dkflsrj/processor-test/wiki/PerfomanceTime.wiki

#summary Времена выполнения микроконтроллером разных процессов

|| *Процесс* || *Время выполнения* ||
||Запуск МК||~300мкс||
||Время съём байта TIC||4мкс||
||Общее время съёма пакет HVE||~72мкс||
||Время декодирования HVE пакета||~13мкс||
||Время на отправку запроса HVE (с таймером)||~3 500мкс||
||Время на отправку CRITICAL_ERROR||~250мкс||
||Переключение pin_iHVE через gpio||~5мкс||
||Переключения iHVE (PORTC.3): [OUT,CLR,SET,TGL]||~350нс||
