dkflsrj/processor-test/Papers/Исследования.ods

DAC | ADC + | + V | ADC - | - V | ADC +/- | V +/- | k + | k - | k(+V) | k(-V) | k(DAC+) | k(DAC-)
5000 | 502 | 61,11 | 481 | 60,31 | 4,18% | 1,31% | 9,960 | 10,395 | 8,215 | 7,975 | 81,820 | 82,905
5500 | 551 | 67,27 | 529 | 66,3 | 3,99% | 1,44% | 9,982 | 10,397 | 8,191 | 7,979 | 81,760 | 82,956
6000 | 602 | 73,44 | 577 | 72,3 | 4,15% | 1,55% | 9,967 | 10,399 | 8,197 | 7,981 | 81,699 | 82,988
6500 | 652 | 79,6 | 625 | 78,29 | 4,14% | 1,65% | 9,969 | 10,400 | 8,191 | 7,983 | 81,658 | 83,025
