dkflsrj/processor-test/Papers/Конференция/Доклад .odt

### Отладочные средства

### систем сбора данных и управления параметрами

### на базе микроконтроллера ATxmega32A4

### в приборах физического эксперимента

Системы сбора данных и управления параметрами в физических экспериментах часто строятся с использованием микроконтроллеров. Так для управления узлами, создаваемого в лаборатории масс-спектрометра был выбран микроконтроллер типа ATxmega32A4. Для отладки его многочисленных функций целесообразно осуществить предварительную разработку и отладку программного обеспечения микроконтроллера. В данном докладе рассмотрены отладочные средства, включающие специально разработанную плату и компьютерную программу, обеспечивающие разработку и отладку программного обеспечения аппаратуры, создаваемой на микроконтроллере типа ATxmega32A4.

Микроконтроллер ATxmega32A4 и его основные возможности.

XMEGA A — семейство экономичных, высокопроизводительных микроконтроллеров, выполненных по улучшенной RISC-архитектуре AVR. Микроконтроллер ATxmega32A4 интегрирует следующие ресурсы:

- внутрисистемно-программируемая Flash-память,
- внутренние EEPROM и SRAM,
- четырёхканальный DMA-контроллер,
- восьмиканальная система событий,
- программируемый многоуровневый контроллер прерываний,
- 34 линии ввода-вывода общего назначения,
- 16-битный счётчик реального времени (RTC),
- пять 16-битных таймер-счётчиков,
- пять интерфейсов USART,
- два интерфейса SPI,
- интерфейс внутрисхемного программирования PDI
- точный внутренний генератор и предделитель частоты,
- и другое...
