dkflsrj/processor-test/Papers/Others/commands.htm

Команды масспектрометра

Cmd_GetState (0x01)

Возвращает текущее состояние масспектрометра:

Командв: 0x01

Ответ: 0x01 <SystemState>

enum SystemStates

{

SystemStart = 0,

SystemInit = 1,

SystemVacuumInit = 2,

SystemVacuumCrash = 3,

SystemReady = 4,

SystemBringingProbe = 5,

SystemMeasuring = 6,

SystemMeasured = 7,

SystemMeasuredReady = 8,

SystemPreShutdown = 9,

SystemShutdown = 10

};

Cmd_GetStatus (0x02)

Возвращает статусную информацию о системе

Команда: 0x02

Ответ: 0x02 <SystemState> <VacuumState> <Forvacuum> <HighVacuum> <HeatCurrent> <EmissionCurent> <IonizationVoltage> <FocusVoltage1> <FocusVoltage2> <ScanVoltage> <CondenserVoltagePositive> <CondenserVoltageNegative> <DetectorVoltage> <RelaysValvesState>

Где:

<SystemState>

enum SystemStates

{

SystemStart = 0,

SystemInit = 1,

SystemVacuumInit = 2,

SystemVacuumCrash = 3,

SystemReady = 4,

SystemBringingProbe = 5,

SystemMeasuring = 6,

SystemMeasured = 7,

SystemMeasuredReady = 8,

SystemPreShutdown = 9,

SystemShutdown = 10

};

<VacuumState>

enum VacuumStates

{

VacuumIdle = 0,

VacuumInit = 1,

VacuumWaitForvacuum = 2,

VacuumCheckForvacHvac = 3,

VacuumWaitOpenHValve = 4,

VacuumWaitForvacuum2 = 5,

VacuumWaitHighvacuum = 6,

VacuumReady = 7,

VacuumBringProbe = 8,

VacuumBringProbeWaitHvacuum = 9,

VacuumForvacuumCrash = 10,

VacuumForvacuumCrashTime = 11,

VacuumForvacuumCrashTime2 = 12,

VacuumHighvacuumCrash = 13,

VacuumHighvacuumCrashTime = 14,

VacuumShutdown = 15

};

<Forvacuum> <HighVacuum> <HeatCurrent> <EmissionCurent> <IonizationVoltage> <FocusVoltage1> <FocusVoltage2> <ScanVoltage> <CondenserVoltagePositive> <CondenserVoltageNegative> <DetectorVoltage>

Соответствующие значения АЦП. Каждое значение представлено 16-битным числом (младший бай первый в пакете), действительных бит – 12 (т.е. старшие 4 бита не используются).

<RelaysValvesState>

Текущее состояние всех реле и клапанов. Каждый би отвечает за соответствующее реле или клапан:

0 – ForvacuumPumpState : 0 – форвакуумный насос выключен, 1 – включен

1 – AtmLapValve: 0 – клапан выхода в атмосферу закрыт, 1 – открыт

2 – HighVacuumValve: 0 - клапан между высоковакуумным насосом и форвакуумом закрыт, 1 – открыт

3 – HeatValve: 0 – тепловой вентиль закрыт, 1 – открыт

4 – PackRelay: 0 – отжимное реле экстрактора (карамысла) выключено, 1 – включено

5 – BringProbeRelay: 0 – реле введения пробы выключено, 1 – включено

6 – RotationRelay: 0 – реле вращения карамысла выключено, 1 – включено

7 – HVHardwEnabled: 0 – высокое напряжение запрещено аналоговой частью, 1 – разрешено (не обязательно включено, это просто превышение минимального порога; высокое напряжение включается только при переходе системы в состояние SystemReady при условии, что бит HVHardwEnabled находится в состоянии 1).

В эту команду так же будет добавлена информация о высоковакуумном насосе (температура, RPM и состояние – включен или выключен).

Cmd_Shutdown (0x03)

Переводит систему в состояние Shutdown. При этом все узлы приводятся в первоначальное состояние. Выход из этого состояние возможен только по команде Cmd_Init.

Cmd_Init (0x04)

Запускает инициализацию системы (в том числе откачку вакуума). Команда может быть исполнена только при нахождении системы в состояниях SystemVacuumCrash, SystemShutdown.

Cmd_SetHeatCurrent (0x05)

Устанавливает значение тока нагрева.

Формат: 0x05 <dataL> <dataH>

Передаются в качестве значения тока два байта (т.е. 16-битное число), но действующими битами являются только младшие 12. При непопадании данных в заданный диапазон (12-бит), генерируется ошибочный ответ (Error_InvalidData).

Cmd_SetEmissionCurrent (0x06)

Устанавливает значение тока эмиссии.

Формат: 0x06 <dataL> <dataH>

Передаются в качестве значения тока два байта (т.е. 16-битное число), но действующими битами являются только младшие 12. При непопадании данных в заданный диапазон (12-бит), генерируется ошибочный ответ (Error_InvalidData).

Cmd_SetIonizationVoltage (0x07)

Устанавливает значение напряжения ионизации.

Формат: 0x07 <dataL> <dataH>

Передаются в качестве значения напряжения два байта (т.е. 16-битное число), но действующими битами являются только младшие 12. При непопадании данных в заданный диапазон (12-бит), генерируется ошибочный ответ (Error_InvalidData).

Cmd_SetFocusVoltage1 (0x08)

Устанавливает значение первого фокусирующего напряжения.

Формат: 0x08 <dataL> <dataH>

Передаются в качестве значения напряжения два байта (т.е. 16-битное число), но действующими битами являются только младшие 12. При непопадании данных в заданный диапазон (12-бит), генерируется ошибочный ответ (Error_InvalidData).

Cmd_SetFocusVoltage2 (0x09)

Устанавливает значение первого фокусирующего напряжения.

Формат: 0x09 <dataL> <dataH>

Передаются в качестве значения напряжения два байта (т.е. 16-битное число), но действующими битами являются только младшие 12. При непопадании данных в заданный диапазон (12-бит), генерируется ошибочный ответ (Error_InvalidData).

Cmd_SetScanVoltage (0x0a)

Устанавливает значение сканирующего напряжения.

Формат: 0x0a <dataL> <dataH>

Передаются в качестве значения напряжения два байта (т.е. 16-битное число), но действующими битами являются только младшие 12. При непопадании данных в заданный диапазон (12-бит), генерируется ошибочный ответ (Error_InvalidData).

Cmd_SetCondenserVoltage (0x0b)

Устанавливает значении напряжения конденсатора.

Формат: 0x0b <dataL> <dataH>

Передаются в качестве значения напряжения два байта (т.е. 16-битное число), но действующими битами являются только младшие 12. При непопадании данных в заданный диапазон (12-бит), генерируется ошибочный ответ (Error_InvalidData).

Cmd_Measure (0x0c)

Запускает измерение одной точки. В качестве данных передается время ожидания до начала измерения (время установления ScanVoltage) и время измерения. Ответ на команду – что команда исполнена. После чего система переходит в состояние SystemMeasuring. По окончании измерения (истечении времени ожидания и вемени измерения) система переходит в состояние SystemMesaured и генерируется асинхронное сообщение Async_Measured. После чего может быть послана команда Cmd_GetCounts.

Формат: 0x0c <WaitTimeL> <WaitTimeH> <MeasureTimeL> <MeasureTimeH>

Время задается в 5-миллисекундных интервалах.

Cmd_GetCounts (0x0d)

Читает значение счетчиков и переводит систему из состояние SystemMeasured в состояние SystemReady.

Формат: 0x0d

Ответ: 0x0d <Detector0L> <Detector0M> <Detector0H> <Detector1L> <Detector1M> <Detector1H>

Ответом является пакет, в котором содержатся 24-битные значения счетчиков двух детекторов. Каждое значение идет младшим байтом вперед.

Cmd_RotateExtractor (0x0e)

Запускает процедуру вращения экстрактора (коромысла). Т.е. отжимает экстрактор, переворачивает, прижимает.

Cmd_RotateExtractorGetState (0x0f)

Возвращает текущее состояние вращения экстрактора.(0 – Stopped, 1 – Rotating). Позволяет узнать когда экстрактор закончил вращение.

Формат: 0x0f

Ответ: 0x0f <State>

Cmd_BringProbe (0x10)

Вводит пробу в экстрактор. В качестве данных передается количество впрысков.

Формат: 0x10 <Num>

Где Num – количество впрысков.

Cmd_EnableHeatCurrent (0x11)

Включает или выключает ток нагрева. Если данные равны 0 – то выключает, если не равны нулю – то включает.

Формат: 0x11 <Enable:bool>

Cms_EnableEmissionCurrent (0x12)

Включает или выключает ток эмиссии. Если данные равны 0 – то выключает, иначе – включает.

Формат: 0x12 <Enable:bool>

Так же возможны ответы на команды в случае каких-либо ошибок:

enum ErrorReplyes

{

Error_InvalidCommand=64,

Error_InvalidChecksum=128,

Error_InvalidPacket = 129,

Error_InvalidLength = 130,

Error_InvalidData = 131,

Error_InvalidState = 132

};

Error_InvalidCommand – неверный код команды (команды с таки кодом нет)

Error_InvalidChecksum – неверная контрольная сумма пакета

Error_InvalidPacket – ошибки при принятии пакета (типа overrun или что-то подобное)

Error_InvalidLength – неверная длинна пакета/данных

Error_InvalidData – неверные данные (например выходят за допустимый диапазон)

Error_InvalidState – команда не может быть исполнена в текущем состоянии системы

Возможны асинхронные пакеты, которые сообщают о каком-то событии в системе:

enum AsyncReplyes

{

InternalError = 192,

InternalError_InvalidSystemState = 193,

AsyncError_VacuumCrash = 194,

Async_Measured=224,

Async_VacuumReady = 225,

Async_SystemShutdowned = 226,

Async_Init = 227

};

InternalError – полный трынцец. Случилось что-то страшное. Срочно все выключаем. Никогда не должно возникнуть. Данные, пересланные в этом пакете необходимо сохранить и показать мне.

InternalError_InvalidSystemState – почти полный трындец. Почему-то возникло неизвестное системное состояние. Срочно выключаем. Никогда не должно возникнуть. Аналогично – все данные отсюда надо сохранить и показать мне.

AsyncError_VacuumCrash – что-то страшное случилось с вакуумом. Т.е. либо форвакуум, либо высокий вакуум стал хуже заданного порога. В качестве данных передается состояние вакуума. Более подробную информацию можно получить по команде Cmd_GetStatus.

Async_Measured – измерение закончено.

Async_VacuumReady – вакуум перешел в состояние VacuumReady, следовательно система перешла в состояние SystemReady и готова к измерению.

Async_SystemShutdowned – система перешла в состояние SystemShutdown (по команде Cms_Shutdown).

Async_Init – запущена циклограмма инициализации системы/вакуума (либо при включении питания, либо по команде Cmd_Init).
