dkflsrj/processor-test/Papers/Others/Прибор/1-3-poryadok_vkl_med-pribora.bmp

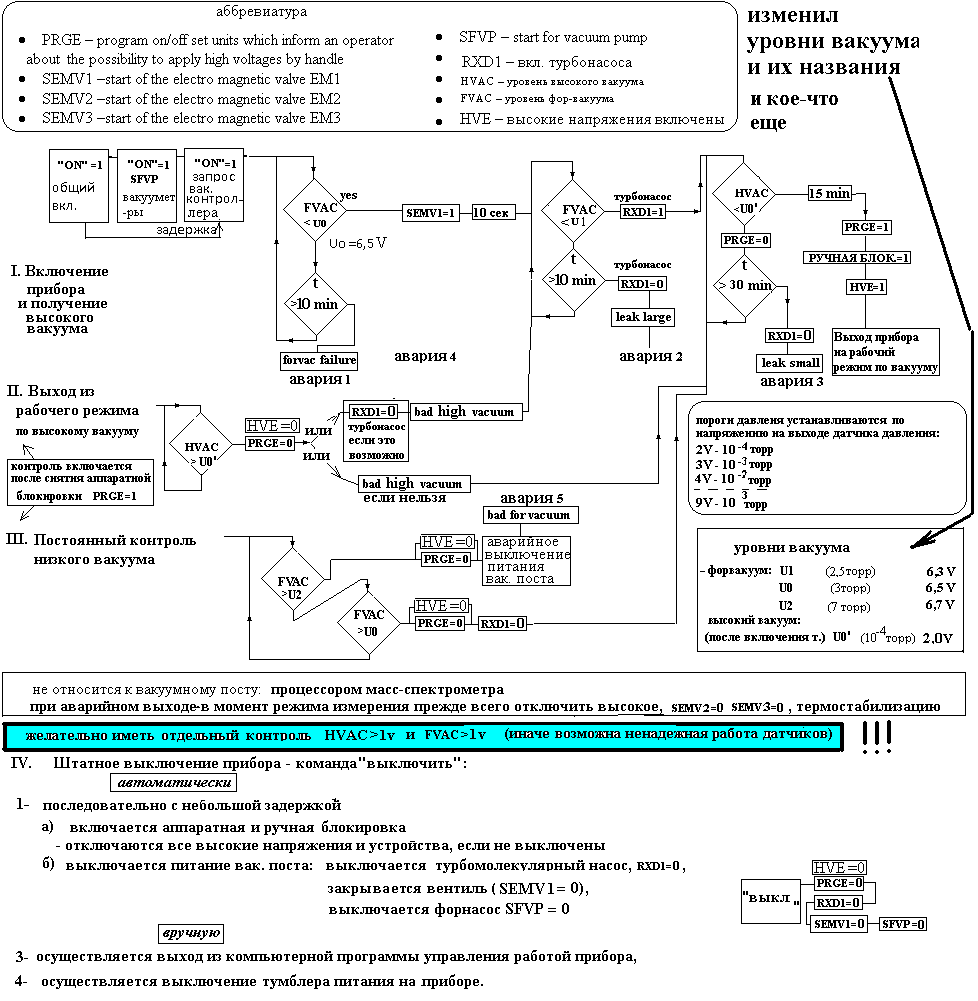
Papers/Others/Прибор/1-3-poryadok_vkl_med-pribora.bmp
