dkflsrj/processor-test/Papers/Конференция/Картинки/pic_3_1.GIF

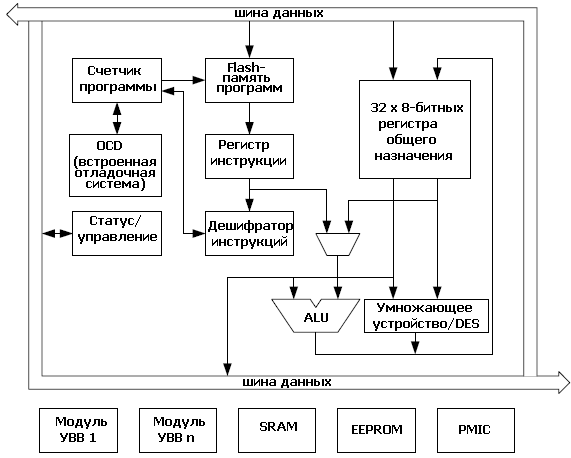
Papers/Конференция/Картинки/pic_3_1.GIF
