dkflsrj/processor-test/Papers/Конференция/Картинки/Схема МК семейства XMEGA A.gif

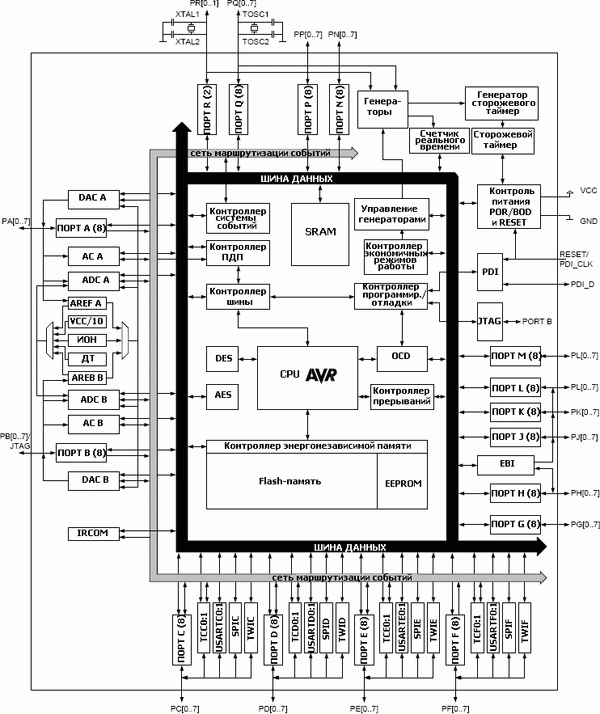
Papers/Конференция/Картинки/Схема МК семейства XMEGA A.gif
