dkflsrj/processor-test/Papers/Конференция/Картинки/Схема установки.PNG

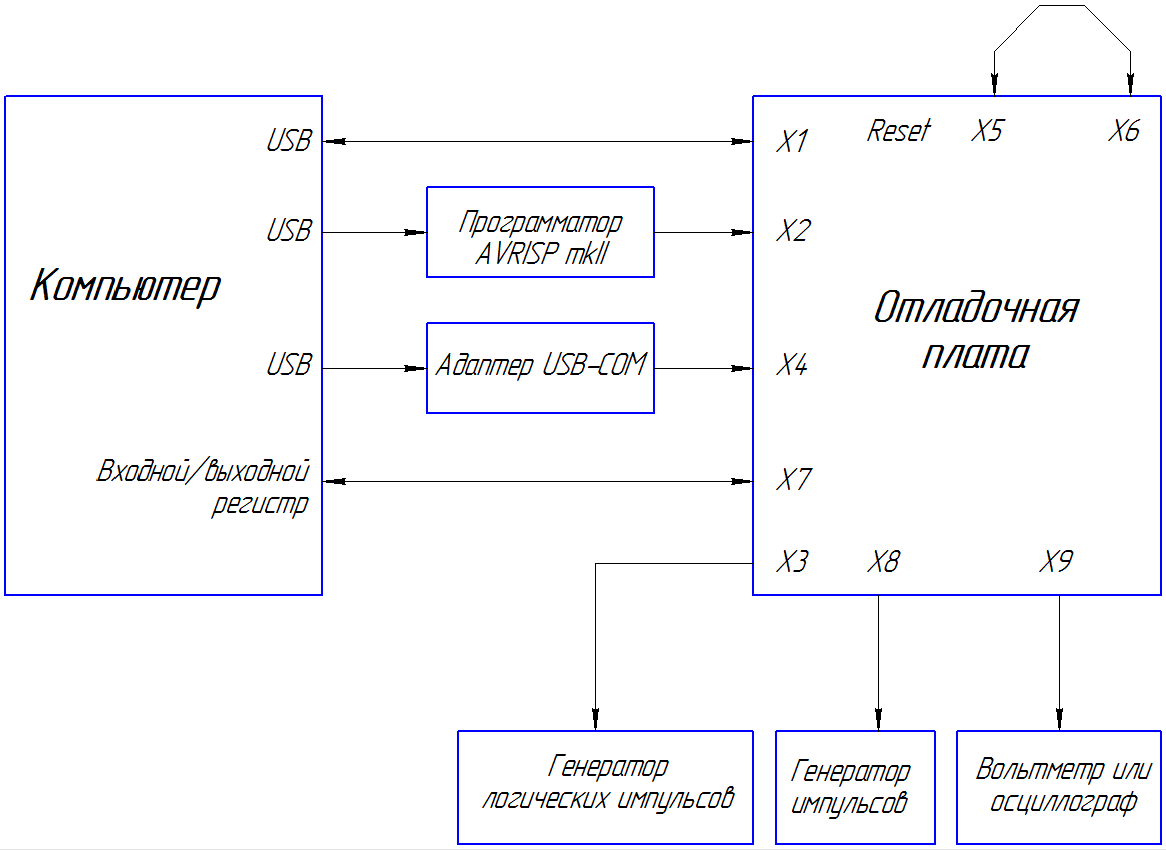
Papers/Конференция/Картинки/Схема установки.PNG
