dkflsrj/processor-test/PCAD/Test/Чичагов/Controller Test.XLS

 |  |  |  |  |  |  |  |  | ИЗМ.
ЗАКАЗЧИК |  |  |  |  |  |  |  | вер. 13.10.07
Название фирмы (или ФИО) - заказчика |  |  |  | ИНН\КПП | ФТИ им.Иоффе
Плательщик (если различно с заказчиком) |  |  |  | ИНН\КПП | ООО “МАКСВЕЛЛ” ИНН 7814122106 КПП 780401001
Адрес (юридический) |  |  |  |  | Адрес:195257, г. С. -Петербург, пр. Северный, д.73/2-54
Телефон / Факс |  |  |  |  | тел. 2927962, +79112877645, 2927361 факс. (812) 297-3145
e-mail |  |  |  |  | tuboltsev@mail.ioffe.ru
Контактное лицо |  |  |  |  | Тубольцев Юрий Владимирович
Способ доставки |  | Адрес доставки |  |  | Самовывоз
Характеристика проекта |  |  |  |  | Все значения и требования отличные от стандартных необходимо дописывать в поле "ДОПОЛНИТЕЛЬНЫЕ ТРЕБОВАНИЯ"
Название файла платы: |  |  |  |  | Controller Test.pcb
Тип заказа |  |  |  |  | Новый
Вариант производства |  |  |  |  | Срочное изготовление(2-4дня)
Количество, шт. |  |  |  |  | 1
Размер платы (длина), мм
Размер платы (ширина), мм
Общая площадь платы, дм*дм (вычисляется автоматически)
Формат файлов
Общая толщина платы, мм (по умолчанию 1,5мм) |  |  |  |  | 1.50
Толщина фольги, мкм (по умолчанию 18мкм) |  |  |  |  | 18
Количество слоев |  |  |  |  | 2
Наличие маски |  |  |  |  | с 2 сторон
Наличие маркировки краской |  |  |  |  | Отсутствует
Переходные отверстия (по умолчанию закрыты маской) |  |  |  |  | Открыты от маски
Масштаб изготовления фотошаблона
Мехобработка контура (по умолчанию на выбор производства) |  |  |  |  | Фрезерование
Электроконтроль |  |  |  |  | нет
Монтаж в нашей фирме |  |  |  |  | нет
Дополнительные требования
Перечень технологических слоев (предполагается описание максимум 5 проектов при одинаковой структуре слоев)
Указать, какие характеристики каждого слоя включить в вашем проекте, пометить любым знаком
Верхний | Нижний |  | Маска верх | Маска низ |  | контур
Top | Bottom |  | MaskTop | MaskBot |  | Border
RefDes | RefDes |  | Pad | Pad
Type | Type |  | RefDes | RefDes
Value | Value |  | Type | Type
 |  |  | Value | Value
 |  |  |  |  |  |  | другие слои не указанные выше, (если есть или отличаются)
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
