dkflsrj/processor-test/Papers/ListOfCommandsForTestBoard.ods

Sheet: Структура пакетов
Любая команда ПК имеет вид: |  |  |  | <KEY><command><data><CS><LOCK> | До 10 байт
Любой ответ МК имеет вид: |  |  |  | <KEY><response><data><CS><LOCK> | Любого размера
Блок | Кол. Байт | Число | Символ
<KEY> | 1 | 58 | :
<command> | 1 | any | any
<data> | any | any | any
<CS> | 1 | 256 - <command> - <data>
<LOCK> | 1 | 13 | \r
<response> | 1 | <command> или <ErrorToken>
<ErrorTocken> | 1 | 0

Sheet: Команды
Код | Название |  |  |  |  | Данные |  | Описание
 | МК | ПК |  |  | Коротко | Посылаемые | Принимаемые
 |  | Тип | Имя | Перезагрузки
0 | ErrorToken | - | - | - | Метка ошибки | ? | 2 байта | Отклик МК, означающий, что следующие данные содержат информацию об ошибке
1 | MC_get_Version | byte | getVersion | - | Запросить версию прошивки МК | - | 1 байт | МК возвращает версию прошивки МК
2 | MC_get_Birthday | string | getBirthday | - | Запросить дату создания прошивки | - | 4 байта | МК возвращает дату создания прошивки МК
3 | MC_get_CPUfreq | string | getCPUfrequency | - | Запросить частоту МК | - | 4 байта | МК возвращает частоту процессора (не вычисляется)
4 | MC_reset | bool | reset |  | Перезагрузка МК | - | - | МК перезагружается [НЕ РАБОТАЕТ – ОТКЛЮЧЕНО]
5 | MC_wait | void | setMCwait |  | Перевод в режим ожидания | - | - | Переводит МК в режим ожидания [НЕ РАБОТАЕТ – ОТКЛЮЧЕНО]
6
7
8 | checkCommandStack | bool | checkCommandStack | - | Проверить стек команд | - | 1 байт | МК возвращает CommandStack (ПК и МК считают выполненные команды)
9
10 | showMeByte | void | showMeByte(BYTE) | byte \ string \ uint | Показать байт на светодиодах | 1 байт | - | МК показывает byte на светодиодах. [ОТКЛИК ОТКЛЮЧЕН]
11 | retransmitToTIC | void | sendToTIC | - | Ретранслировать команду на TIC | ? | ? | МК ретранслирует команду TIC'у, ивозвращает компьютеру ответ TIC'a [В РАЗРАБОТКЕ...]
12
13 | LOCK | - | - | - | Затвор | - | - | \r' – Конец команды. Любая команда заканчивается этой
14
15
16
17
18
19
20 | MC_get_Status | byte | getStatus | - | Запросить состояние МК | - | - | Возвращает код состояния МК
21
22
23
24
25
26
27
28
29
30 | RTC_set_Period | bool | COUNTERS.setMeasureTime(MILLISECONDS) | uint | string | Задать время измерения | 2 байта | 1 байт | Задаёт время измерения от 1мс до 2047с. Возвращает статус RTC
31 | COUNTERS_start | bool | COUNTERS.startMeasure | - | Начать счёт | - | 1 байт | Счётчики начинаю считать импульсы, а RTC – время. Возвращает статус
32 | COUNTERS_get_Count | string | COUNTERS.getResults | - | Запросить у счётчиков результаты | - | 15 байт | Запросить у счётчиков результаты и переполненность
33 | COUNTERS_stop | bool | COUNTERS.stopMeasure |  | Остановить счётчики | - | - | Счётчики останавливаются, результаты сбрасываются. RTC останавливается и сбрасывается
34 | RTC_set_Prescaler | bool | COUNTERS.setPrescaler(PRESCALER) | ushort | Задать делитель RTC | 1 байт | - | RTC устанавливает соответствующий делитель
35 | RTC_get_Status | string | COUNTERS.getStatus | - | Запросить статус RTC | - | 1 байт | МК возвращает статус RTC
36 | RTC_set_Delay | bool | COUNTERS.setDelay(MILLISECONDS) | uint | string | Задать время задержки | 2 байт | - | Задаёт время задержки от 1мс до 2047с. Возвращает true – удалось, false – отмена
37 | RTC_startDelay | byte | COUNTERS.startDelay() |  | Принудительно начать задержку (таймер) | - | 1 байт | Принудительно начинает задержку, может работать как таймер.
38 | RTC_set_DelayPrescaler | bool | COUNTERS.setDelayPrescaler(MILLISECONDS)
39
40 | IonSource_set_Voltage | bool | IonSource.<...>.setVoltage(VOLTAGE) | ushort | string| int | Задать напряжение DAC'у Ионного Источника | 2 байта | - | МК задаёт напряжение на DAC Ионного Источника на канал <...>
41 | Detector_set_Voltage | bool | Detector.<...>.setVoltage(VOLTAGE) | ushort | string| int | Задать напряжение DAC'у Детектора | 2 байта | - | МК задаёт напряжение на DAC Детектора на канал <...>
42 | Scaner_set_Voltage | bool | Scaner.<...>.setVoltage(VOLTAGE) | ushort | string| int | Задать напряжение DAC'у Сканера | 2 байта | - | МК задаёт напряжение на DAC Сканера на канал <...>
43 | Condensator_set_Voltage | bool | Condensator.setVoltage(VOLTAGE) | ushort | string| int | Задать напряжение конденсатора | 2 байта | - | МК задаёт напряжение на DAC Конденсатора на канал единственный используемый канал
44
45
46
47
48
49 | Inlet_set_Voltage | bool | Inlet.setVoltageVOLTAGE() | ushort | string| int | Задать напряжение натекателя | 2 байта | - | МК задаёт напряжение на DAC Натекателя на канал Натекателя
50 | Heater_set_Voltage | bool | Heater.setVoltage(VOLTAGE) | ushort | string| int | Задать напряжение нагревателя | 2 байта | - | МК задаёт напряжение на DAC Натекателя на канал Нагревателя
51
52
53
54
55
56
57
58 | KEY | - | - | - | Ключ | - | - | :' - Начало команды. Любая команда начинается с этой.
59
60 | IonSource_get_Voltage | ushort | IonSource.<...>.getVoltage | - | Запросить напряжение у ADC Ионного Источника | 2 байта | 2 байта | МК возвращает напряжение DAC Ионного Источника на канале <...>
61 | Scaner_MSV_get_Voltage | ushort | Scaner.<...>.getVoltage | - | Запросить напряжение у ADC Сканера | 2 байта | 2 байта | МК возвращает напряжение DAC Сканера на канале <...>
62
63
64 | Detector_DV1_get_Voltage | ushort | Detector.DV1.getVoltage | - | Запросить напряжение DV1 | 2 байта | 2 байта | МК возвращает напряжение DAC Детектора на канале DV1
65 | Detector_DV2_get_Voltage | ushort | Detector.DV2.getVoltage | - | Запросить напряжение DV2 | 2 байта | 2 байта | МК возвращает напряжение DAC Детектора на канале DV2
66 | Detector_DV3_get_Voltage | ushort | Detector.DV3.getVoltage | - | Запросить напряжение DV3 | 2 байта | 2 байта | МК возвращает напряжение DAC Детектора на канале DV3
67 | Inlet_get_Voltage | ushort | Inlet.getVoltage | - | Запросить напряжение натекателя | 2 байта | 2 байта | МК возвращает напряжение DAC Натекателя на канале Натекателя
68 | Heater_get_Voltage | ushort | Heater.getVoltage | - | Запросить напряжение нагревателя | 2 байта | 2 байта | МК возвращает напряжение DAC Натекателя на канале Нагревателя
69
70
71
72
73
74
75
76
77
78
79
80 | Flags_set | byte | .setFlags | byte | Устанавливаем флаги на пинах | 1 байт | 1 байт | Посылает на МК 8 бит: <Проверить\Установить><0> и 6 флагов <iHVE><iEDCD><SEMV1><SEMV2><SEMV3><SPUMP>. МК возвращает флаги в том же порядке.
81
82
83
84
85
86
87

Sheet: Ошибки
Код | Тип | Название |  | Описание | Заметки
 |  | MC | Ru
0 | Token | ERROR_Token | Метка ошибки | Метка ошибки присылается как отклик на команду, после идут данные об ошибке.
1 | external_error | ERROR_Decoder | Ошибка декодера (Команда) | МК не может интерпретировать команду. Такой команды не существует.
2 | external_error | ERROR_WhereIsKEY | Ошибка декодера (Ключ) | МК не обнаружил КЛЮЧ в полученной команде.
3 | external_error | ERROR_WhereIsLOCK | Ошибка декодера (Затвор) | МК не обнаружил ЗАТВОР в полученной команде.
4 | external_error | ERROR_CheckSum | Ошибка декодера (Контр.сумма) | Контрольная сумма полученной команды не совпадает с подсчитанной
5 | internal_error | ERROR_wrong_SPI_DEVICE_Number | Ошибка номера SPI устройства | МК было приказано обратиться к неизвестному SPI устройству. Не должна возникнуть
6
7
8
9
10
11
12
13
14
15
16
17
18
19
20
21
22
23
24
25
26
27
28
29
30
31
32
33
34
35

Sheet: Класс
СТРУКТУРА КЛАССА
MC | getErrorList() |  |  | List<string> | Возвращает список возникших при работе ошибок, которые были записаны классом.
 | Chip | setUSART(SerialPort) |  | - | Задаёт COM порт. Необходимо для инициализации
 |  | getStatus() |  | byte | Возвращает статус самого микроконтроллера
 |  | getVersion() |  | byte | Возвращает версию прошивки микроконтроллера
 |  | getBirthday() |  | string | Возвращает дату создания прошивки микроконтроллера
 |  | getCPUFrequency() |  | string | Возвращает частоту процессора микроконтроллера (не вычисляется)
 |  | checkCommandStack() |  | bool | Проверяет синхронность команд ПК-МК.
 | Tester | setTracer(RichTextBox) |  | - | Задаёт RichTextBox для вывода сообщений (опционально)
 |  | enableTracer(bool) |  | - | Включает\выключает вывод сообщений
 |  | enableLog(bool) |  | - | Включает\выключает вывод сообщений в текстовый файл Log.txt
 |  | sendSomething() |  | - | ТЕСТОВОЕ – посылает число 243 микроконтроллеру
 |  | showMeByte(byte | string | uint) |  | - | ТЕСТОВОЕ - Посылает микроконтроллеру байт, который он высвечивает на светодиодах
 | IonSource | EmissionCurrent | setVoltage(ushort | int | string) | - | Задаёт напряжение Эмиссионного Тока Ионного Источника
 |  |  | getVoltage() | ushort | Возвращает напряжение Эмиссионного Тока Ионного Источника
 |  |  | enableDoubleRange(bool) | - | Включает\выключает двойной диапазон снятия напряжения (для getVoltage() ) | <-
 |  | Ionization | setVoltage(ushort | int | string) | - | Задаёт напряжение Ионизации Ионного Источника
 |  |  | getVoltage() | ushort | Возвращает напряжение Ионизации Ионного Источника
 |  |  | enableDoubleRange(bool) | - | Включает\выключает двойной диапазон снятия напряжения (для getVoltage() ) | <-
 |  | F1 | setVoltage(ushort | int | string) | - | Задаёт напряжение Фокусное 1 Ионного Источника
 |  |  | getVoltage() | ushort | Возвращает напряжение Фокусное 1 Ионного Источника
 |  |  | enableDoubleRange(bool) | - | Включает\выключает двойной диапазон снятия напряжения (для getVoltage() ) | <-
 |  | F2 | setVoltage(ushort | int | string) | - | Задаёт напряжение Фокусное 2 Ионного Источника
 |  |  | getVoltage() | ushort | Возвращает напряжение Фокусное 2 Тока Ионного Источника
 |  |  | enableDoubleRange(bool) | - | Включает\выключает двойной диапазон снятия напряжения (для getVoltage() ) | <-
 |  | reset() |  | bool | Сбрасывает DAC Ионного Источника (Все напряжения на 0)
 |  | enableDoubleRange(bool) |  | - | Включает\выключает двойной диапазон снятия напряжений (для getVoltage() ) всем сразу. | ->
 | Detector | DV1 | setVoltage(ushort | int | string) | - | Задаёт напряжение DV1 Детектора
 |  |  | getVoltage() | ushort | Возвращает напряжение DV1 Детектора
 |  |  | enableDoubleRange(bool) | - | Включает\выключает двойной диапазон снятия напряжения (для getVoltage() ) | <-
 |  | DV2 | setVoltage(ushort | int | string) | - | Задаёт напряжение DV2 Детектора
 |  |  | getVoltage() | ushort | Возвращает напряжение DV2 Детектора
 |  |  | enableDoubleRange(bool) | - | Включает\выключает двойной диапазон снятия напряжения (для getVoltage() ) | <-
 |  | DV3 | setVoltage(ushort | int | string) | - | Задаёт напряжение DV3 Детектора
 |  |  | getVoltage() | ushort | Возвращает напряжение DV3 Детектора
 |  |  | enableDoubleRange(bool) | - | Включает\выключает двойной диапазон снятия напряжения (для getVoltage() ) | <-
 |  | reset() |  | bool | Сбрасывает DAC Детектора (Все напряжения на 0)
 |  | enableDoubleRange(bool) |  | - | Включает\выключает двойной диапазон снятия напряжений (для getVoltage() ) всем сразу. | ->
 | Scaner | ParentScan | setVoltage(ushort | int | string) AD5643R | - | Задаёт напряжение Родительское Сканирующее Сканера
 |  |  | getVoltage() | ushort | Возвращает напряжение Родительское Сканирующее Сканера
 |  |  | enableDoubleRange(bool) | - | Включает\выключает двойной диапазон снятия напряжения (для getVoltage() ) | <-
 |  | Scan | setVoltage(ushort | int | string) AD5643R | - | Задаёт напряжение Сканирующее Сканера
 |  |  | getVoltage() | ushort | Возвращает напряжение Сканирующее Сканера
 |  |  | enableDoubleRange(bool) | - | Включает\выключает двойной диапазон снятия напряжения (для getVoltage() ) | <-
 |  | reset() AD5643R |  | bool | Сбрасывает DAC Сканера (Все напряжения на 0)
 |  | enableDoubleRange(bool) |  | - | Включает\выключает двойной диапазон снятия напряжений (для getVoltage() ) всем сразу. | -> | ->| | |<-
 | Heater | setVoltage(ushort | int | string) |  | - | Задаёт напряжение Нагревателя
 |  | getVoltage() |  | ushort | Возвращает напряжение Нагревателя
 |  | reset() |  | bool | Сбрасывает DAC Нагревателя и Натекателя (Все напряжения на 0) | ->
 |  | enableDoubleRange(bool) |  | - | Включает\выключает двойной диапазон снятия напряжений (для getVoltage() ) | ->
 | Inlet | setVoltage(ushort | int | string) |  | - | Задаёт напряжение Натекателя
 |  | getVoltage() |  | ushort | Возвращает напряжение Натекателя
 |  | enableDoubleRange(bool) |  | - | Включает\выключает двойной диапазон снятия напряжений (для getVoltage() ) | ->
 |  | reset() |  | bool | Сбрасывает DAC Нагревателя и Натекателя (Все напряжения на 0) | ->
 | Condensator | setVoltage(ushort | int | string) AD5643R |  | - | Задаёт напряжение Конденсатора
 |  | getPositiveVoltage() |  | ushort | Возвращает напряжение Положительной обкладки Конденсатора
 |  | getNegativeVoltage() |  | ushort | Возвращает напряжение Отрицательной обкладки Натекателя
 |  | enableDoubleRange(bool) |  | - | Включает\выключает двойной диапазон снятия напряжений (для getVoltage() ) | У Конденсатора и Сканера один АЦП, но команды не должны влиять друг на друга
 |  | reset() AD5643R |  | bool | Сбрасывает DAC Конденсатора (Все напряжения на 0)
 | ADC | DoubleRange |  | bool | ТЕСТОВОЕ - Булка для вкл\выкл. двойного диапазона.
 |  | getVoltage(byte CHANNEL) |  | ushort | ТЕСТОВОЕ – Возвращает напряжение на канале CHANNEL
 | DAC | setVoltage(byte|string|int CHANNEL, ushort|string|int VOLTAGE) |  | - | ТЕСТОВОЕ – Задаёт напряжение на канал CHANNEL
 |  | reset() |  | bool | ТЕСТОВОЕ – Сбрасывет DAC. (Все напряжения на 0)
 | Counters | COA | overflows | byte | Количество переполнений счётчика. Обновляется командой .receiveResults()
 |  |  | Result | UInt32 | Сосчитанный результат. Обновляется командой .receiveResults()
 |  | COB | overflows | byte | Количество переполнений счётчика. Обновляется командой .receiveResults()
 |  |  | Result | UInt32 | Сосчитанный результат. Обновляется командой .receiveResults()
 |  | COC | overflows | byte | Количество переполнений счётчика. Обновляется командой .receiveResults()
 |  |  | Result | UInt32 | Сосчитанный результат. Обновляется командой .receiveResults()
 |  | setDelay(uint | string MILLISECONDS) |  | bool | Устанавливает время задержки между измерениями(). Возвращает true – если операция удалась. False – если отменена (не должна возникнуть)
 |  | startDelay() |  | byte | Принудительно начинает задержку, может быть использовано как таймер при выключеных счётчиках. Возвращает статус RTC
 |  | getRTCprescaler(uint | string MILLISECONDS) |  | ushort | Класс вычисляет необходимый предделитель RTC , сохраняет и возвращает его.
 |  | getRTCfrequency() |  | double | Класс возвращает частоту RTC в соответствии с сохранённым предделителем.
 |  | getRTCticks(uint | string MILLISECONDS, ushort | string PRESCALER) |  | ushort | Класс возвращает время измерения в тиках RTC.
 |  | setMeasureTime(uint | string MILLISECONDS) |  | bool | Класс вычисляет предделитель, сохраняет и устанавливает его (в МК), вычисляет количество тиков и устанавливает его (в МК). Возвращает статус RTC
 |  | startMeasure() |  | bool | Запускает счёт на заданное setMeasureTime() время. Возвращает true, если операция удалась, false – не удалась (счётчики уже считают)
 |  | stopMeasure() |  | bool | Останавливает счётчики. Возвращает true, если операция удалась, false – не удалась (счётчики не считают)
 |  | getStatus() |  | string | Возвращает статус счётчиков: "Ready" – не заняты, "Busy" – считают, "Stopped" – принудительно остановлены командой stopMeasure()
 |  | receiveResults() |  | string | Сохраняет результаты счётчиков и переполнения в COХ.Result и COХ.overflows. Возвращает статус счётчиков (см. getStatus())
 | TIC | send() |  | - | В РАЗРАБОТКЕ...
