dkflsrj/processor-test/(list of files, drawings)

Other design files:
PCAD/Main/CPU_12.pcb
PCAD/Main/CRB_12.pcb
PCAD/Main/PSIS_12.pcb
PCAD/Test/Controller Test/Controller Test(07.07.13).pcb
PCAD/Test/Controller Test/Controller Test(монтаж).pcb
PCAD/Test/Controller Test/Controller Test-16h(монтаж).pcb
PCAD/Test/Чичагов финиш/CPU-12/CPU_12(finish).pcb
PCAD/Test/Чичагов финиш/CPU-12/CPU_12(монтаж).pcb
PCAD/Test/Чичагов/Controller Test.pcb
PCAD/Test/Чичагов/CPU_08M.pcb
PCAD/Test/Чичагов/CPU_12(5.07.13).pcb
PCAD/Test/Чичагов/CPU_12(finish).pcb
PCAD/Test/Чичагов/CPU_12(монтаж).pcb
PCAD/Test/Чичагов/CPU_12.pcb
PCAD/Test/Чичагов/CPU_контур.pcb
PCAD/Test/Чичагов/Шаблон1.PCB
PCAD/Test/Шаблоны/Шаблон1.PCB
