dkflsrj/processor-test/(commit log)

2013-07-29 Добавление файлов проекта
2013-07-29 Добавление документации
    [ListOfCommandsForTestBoard.ods]
2013-07-29 Чистка, добавление игнорлиста
2013-07-30 Заложены основы системы опроса состояния
2013-07-30 Реализован 32-битный счётчик и адаптивный делитель RTC
    [ListOfCommandsForTestBoard.ods]
2013-07-31 Исправление дефекта: Ресет МК после первой попытки счёта. Причина: Некорректное задание прерывания по переполнению младшего счётчика Решение: Реализация callback функции
    [main.c]
2013-07-31 Исправления системы команд и ответов. Требуются дальнейшие изменения. Часть пользовательского интерфейса заблокирована. Протокол побщения теперь: ':<data><CS>\r' Унифицированна система отправки данны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
    [ListOfCommandsForTestBoard.ods]
2013-08-01 USART: система передачи данных улучшена. Улучшена функция transmit(). Подготовлена почва под систему отклика
2013-08-01 Добавлена некоторая документация по МСП
2013-08-01 Доработка системы команд и отклика. Разблокирована SPI система DAC и ADC Улучшена система tracе'инга (добавлена кнопка "Подробный отчёт") Скорость USART поднята до 128000бод Установлена задержка приё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
2013-08-02 Проведено исследование сэмплирования. Результат: Положительный. Количество сэмплов уменьшено до 3-х. Счетаемая частота: 4,5МГц Счетаемая длинна импульса: от 110нс ------------------------------------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
2013-08-02 Попытка восстановить счётчик. Результат: Неудача. Нужно проанализировать прередаваемые данные.
2013-08-05 Отлажена работа счётчика. Работают функции: 1) Задать интервал 2) Начать счёт 3) Проверить счёт 4) Остановить счёт ------------------------- Работают с учётом состояния счётчика 0 - готов 1 - останов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
    [ListOfCommandsForTestBoard.ods]
2013-08-05 Попытка реализовать функцию программного сброса. Результат: Неудача Проблема: Неизвестно как записать блокирующую сигнатуру в CCP регистр для осуществления броса в регистре RST.CTRL
    [ListOfCommandsForTestBoard.ods]
2013-08-05 Добавлена запись действий с log.txt и кнопка быстрого вызова лога.
2013-08-06 Усовершенствован счётчик. Появилось разделение функций на "установочные" (.setParametr или .getParametr), которые посылают команды МК, и "классовые" (.set_Parametr), которые устанавливают значения ил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
2013-08-06 Чистка, реструктуризация.
2013-08-06 После долгих метаний небольшая чистка, и заложение основ распознания ошибок
2013-08-07 Реализована функция отправки сообщений TIC'у (пока с отражённым ответом)
2013-08-07 Отпочковал главный проект, начал приводить его в порядок. Начал реструктуризацию прошивки для тестовой платы (Выведения счётчиков в структуры)
2013-08-07 Добавление отпочкованного
2013-08-07 Чистка
2013-08-07 Мелкие доработки к системе ошибок.
2013-08-08 Реструктуризация, добавление ЦАПа AD5643R
2013-08-08 Добавление документации AD5643R и проча
2013-08-08 Создан real интерфейс, для будущей отладки нетестового МК. Пока этот интерфейс работает с SPI имеющимися тестовыми DAC и ADC. Увы, но обнаружен очень странный баг с командо 40...
2013-08-09 Исправлена ошибка команды 40. Было совпадение данных и замка (13). Проблема решена: МК ждёт всех байт при помощи специальной задержки, а потом разбирает команду
    [main.c]
2013-08-09 Переработка названий. Пересоставление документации (Нехватает листа ошибок и поястнений к счётчикам)
    [ListOfCommandsForTestBoard.ods]
2013-08-28 Исправлен Bug_22. Отключена переменная ERROR:bool (PC).
    [main.c]
2013-08-28 Добавлены коды команд для DAC'ов и ADC'ов модулей. Только коды. Правка документации.
    [ListOfCommandsForTestBoard.ods]
2013-08-28 Дороботки для mainBoard'у. Выделение отдельных модулей (ЦАПов и АЦПшек) Пока модули прописаны все на один вывод (для тестовой платы), потом надо просто раскомментировать подготовленный код.
    [ListOfCommandsForTestBoard.ods]
2013-08-28 Созданн классы CHIP и TEST для обращений именно к МК и для отладки, соответственно
2013-08-28 Преобразованы некоторые структуры в классы. Появились трудности: reset и DoubleRange (см. Issues)
2013-08-29 Исправлен Defect_23. Реорганизована классовая структура. Добавлен наследник SPI_DEVICE_CHANNEL с reset'ом.
2013-08-29 Мелочь. Функции DAC'ов reset() теперь сообщают о том какой именно DAC сброшен
2013-08-29 Добавлен класс RTC с делением на COA, COB, COC. Класс неиспользуется. Нет предделителя для генератора, чтобы проверить работоспособность класса. Структура RTC не была изменена.
2013-08-29 Исправлен Defect_24. SPI_DEVICE.enableDoubleRange(bool enable) теперь вызывается и ставит двойной диапазон для всех. Но также оставлена возможность (по не знаю) индивидуально задавать SPI_DEVICE_CHAN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
2013-08-29 Добавление документации. Добавлен лист структуры класса XMEGA32A4U с пояснениями. описание структуры счётчиков незавершено.
    [ListOfCommandsForTestBoard.ods]
2013-08-29 Завершение правки документации по структуре класса. Добавлено описание структуры счётчиков
    [ListOfCommandsForTestBoard.ods]
2013-08-29 Глобальная комментаризация. Чистка. Реструктуризация. Вынесен класс TIC_PUMP. Исправление документации
    [ListOfCommandsForTestBoard.ods]
2013-08-30 Глобальная трэйсификация.
2013-08-30 Исправлен Defect_29. МК теперь на команду Counters.stopMeasure() возвращает статус RTC.
    [ListOfCommandsForTestBoard.ods]
2013-09-11 C#:Саммеризация...
2013-09-12 C#: Саммеризация завершена!
2013-09-19 C#: Саммеризация
2013-09-30 C#: Отключение функций тестовой платы. Начало проекта!
2013-09-30 C: Переопределение выводов. Конфигурация всех систем для проектной платы. Работает!
2013-10-07 Проверка SPI slave-сигналов, MISO и CLK. Добавление документации
    [CPU_12(07.07.13-11h).sch, CPU_12.pcb, CPU_12.sch, CPU_12_modi.sch, CRB_12.pcb, CRB_12.sch]
2013-10-07 С#: Создание интерфейса реальных счётчиков. Чистка
2013-10-08 Добавлена флаговая система. Документорование. Чистка.
    [ListOfCommandsForTestBoard.ods]
2013-10-10 Заготовка к DAC'у AD5643R для конденсатора. Для запланированной проверки
2013-10-11 DAC AD5643R работает нормально. C#: Добавлен канал этого ЦАПа. Конденсатор выставляет напряжения.
2013-10-14 Condensator DAC&ADC: Плохая, но рабочая версия. АЦП пропускает биты, слишком скоросной SPI. Будем уменьшать...
2013-10-14 Condensator DAC&ADC: Рабочая версия.
2013-10-15 MSV: Объединение команд обращения к ADC MSV. Всё равно ведь адрес ножки посылается с компьютера...
    [ListOfCommandsForTestBoard.ods, Исследования.ods]
2013-10-15 SPI ADC: Работает нормально. Правильный выбор устроства. Сначала деселект потом селект при чтении, В любых других случаях постоянная запись
2013-10-15 C#: Улучшен трэйсер, саммеризация, функция MC.Tester.setFlags возвращает байт
2013-10-15 C#: Ошибкаризация, чистка...
2013-10-15 C#: ParentScan и Scan напряжения выставляются и контролируются
2013-10-15 C: Конфигурацией ЦАПов AD5643R теперь заправляет МК. МК сам решает когда конфигурировать их. Это зависит от сигнала iHVE. Если iHVE станивотся низким (активным), то МК сбрасывает свои настройки этих 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
2013-10-15 C: Переделана функция автоматического конфигурирования DAC'ов AD5643R платы MSV. Теперь конфигурация происходит при установке флага iHVE Потом надо будет всё равно переделать. Ах, да... кто-то грябор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
2013-10-17 C: Добавлен статус МК: 2 - задание на конфигурацию ЦАПов платы MSV. С#: Убраны функции reset для ЦАПов AD5643R платы MSV.
    [main.c]
2013-10-17 C#: Ошибкаризация. Улучшение трейсеризации отдельных функций
    [ListOfCommandsForTestBoard.ods]
2013-10-18 C: DAC AD5328R Детектора теперь конфигурируется при включении HVE
2013-10-18 C: МК теперь при иницииализации в первую очередь конфигурирует HVE, выключаяя DC-DC 12V
2013-10-21 C: Ускорение инициализации портов. Часть кода переведена на ассемблер для ускорения инициализации портов. ASF слишком медленный (делает циклы с АЛУ), прэтому у него это дело занимает 8,6мс. А теперь 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
2013-10-22 C: Ускорение процессов запуска и остановки счётчиков. Чистка. * Увеличена скорость остановки счётчиков по прерыванию RTC в 6 раз. * Увеличена скорость запуска счётчиков в 13 раз * Удалён MC_Status. О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
2013-10-24 C: Чистка, устранение warning'ов. Начало переработки функционала счётчиков
    [ListOfCommandsForTestBoard.ods]
2013-10-24 C: Продолжение переработки счётчиков. Расстановка меток для возможных ошибок. C#: Скрытие функций reset всех DAC'ов
    [ListOfCommandsForTestBoard.ods]
2013-10-24 C: PSIS DAC 5328 настраиватся через секунду после запуска МК
2013-10-25 C: Смена моды SPI (стробирование по спаду) по многочисленным просьбам PSIS DAC AD5328. Необходимо проверить как это повлияет на другие платы. С#: Замена функции IonSource.reset() на конфигурирование 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
    [PSIS_12.pcb, PSIS_12.sch]
2013-10-25 C,C#: Чистка команд. Команды обращения к DAC'у сведены к одной
    [ListOfCommandsForTestBoard.ods]
2013-10-25 C,C#: Чистка команд.
    [ListOfCommandsForTestBoard.ods]
2013-10-31 C: PSIS DAC AD5328R теперь настраивается на двойной референс и стартовые напряжения при включении iHVE (НЕ ПРОВЕРЕНО!)
2013-11-05 Начало приборки в папке AtmelStudio
2013-11-05 Окончание приборки в папке AtmelStudio. Переименован проект. С: Закоментировано выставление начальных напряжений на Ионном Источнике.
2013-11-19 Правка имени проекта С#
2013-11-19 Правка имени проекта С#...
2013-11-19 C,C#: MEGA-UPDATE 1). C: Убран delay в функциях transmit. (Работает криво, cpu_delay лучше. Но задержка там вообще и не нужна) 2). С: usart_put в функциях transmit заменён на более совершенную usart_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
2013-11-21 С,С#: Чистка. Порядок.
2013-11-21 C,C#: Чистка. МК теперь присылает длину пакета.
2013-11-21 С#: Счётчик теперь пользуется функциями send(...),receive(...),decode(...) в целях универсализации и структуризации.
2013-11-21 C#: Исправлен баг 60. Теперь не надо перезагружать МК после каждой серии измерений. В цикл измерений вставлена проверка на последнее измерение и корректное завершение серии.
    [main.c]
2013-11-21 C#: Мелочь. Теперь сбор данных счётчиков происходит корректно. Раньше не собирались данные о последнем измерении и производилось на 1 измерение больше указанного. Теперь происходит проверка на предпо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
2013-11-21 C#: Исправлен баг 65. Теперь можно сделать одно единственное измерение. + Мелочь. Теперь по окончании серии ПК присылает пакет с указанием "не делать следующее измерение"
    [main.c]
2013-11-21 Form: Теперь форма не зависает на время счёта. Используем поток.
2013-11-22 C#: Попытка запустить мониторинг состояния RTC во время измерения. Неудача.
2013-11-22 С,С#: Теперь во время измерения отсылаются данные для DAC'ов MSV(Сканер и Конденсатор). МК посылает им напряжения. Правильность работы не проверялась!
2013-11-22 C,С#: Коррекция ревизии 91. Теперь напряжения на DAC'ах MSV выставляются во время задержки, или если RTC не считает, то сразу (во время исполнения команды setThemAll)
2013-11-25 C#: Чистка
2013-11-25 C,C#: Теперь во время измерения присылаются данные ADC. Часть команд блокируется на время измерений
2013-11-25 C#: Исправление ошибок связанных с DAC'ами и ADC'шками во время измерения. В конце измерения сохраняются напряжения последней ступени.
    [main.c]
2013-11-25 C#: Чистка. Саммеризация.
2013-11-25 C#: Саммеризация. Counters.Series.Cycles теперь имеет get;set; функции. Введена предстартовая проверка данных перед началом серии измерений
2013-11-25 C#: Оптимизация. Саммеризация
2013-11-25 C#: Теперь компьютер ждёт при команде receive не более TimeOut (~35мс)
2013-11-26 C#: Коррекция ревизии 99. Значения ограничивающие данные для измерения были не верными. DoubleRange теперь константа.
2013-11-26 C#: Симулирование "Проверки 67". Успешно. Скорректирована работа класса при работе с серией в 1-2 ступени измерений
2013-11-26 C,C#: Значительно упрощена работа счётчиков согласно плановому заданию 68.
2013-11-26 C#: Теперь COM-порт всегда открыт. Задача 70. Порт закрывает при закрытии приложения.
2013-11-26 C,C#: МК теперь асинхронно сообщает об окончании измерения. ПК понимающе кивает. Более ничего. ПК обзавёлся обработчиком событий USART_DataReceived, который выключается на время синхронной приём-пере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
2013-11-26 C,C#: Подготовка к сведению transmit и transmit_2. Время ожидания следующего байта для МК уточнено (теперь порядка 1,2 мс) В будущем можно завязать время ожидания на скорости соединения...
2013-11-27 C,C#: Введён сигнал PRGE (Задача 38). Теперь МК сравнивает PRGE и iHVE, если они 1 и 0, соответственно, то включает DC-DC 24-12. iHVE пока что жёстко вшивается в прошивку и устанавливается при инициа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
2013-11-27 C,C#: Улучшение системы ошибок. Теперь есть три класса ошибок: Обычные, Внутренние и Происшествия. Теперь с запросом статуса МК приходит байт флагов происшествий.
2013-11-27 C#: Сведение transmit и transmit_2 к одной функции transmit. + Переименования.
2013-11-27 C,C#:Убрана длина пакета в приём-передаче. Чистка. Изменены метки асинхронных сообщений
2013-11-27 C#: Задание 77 выполнено. Теперь ручной ресет МК не вызывает вылет ПК программы. Сообщается о скачке на линии.
2013-11-27 C#: Частично выполнено задание 81. Теперь ПК не вылетает при неверной длине данных.
2013-11-27 Мелочь. delay_s заменено на cpu_delay_ms
2013-11-27 C,C#: Переименования. Чистка. Оптимизация.
2013-11-27 C#: Исправлен баг 81 (окончательно). Теперь проверяется отклик.
    [main.c]
2013-11-27 C#: Задание 82 отчасти выполнено. Теперь класс имеет статичного делегата EventCallBack MeasureEnd. Который вызывается при приходе LAM сигнала от МК. Цикл измерений работает, но дальнейшие исследовани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
2013-11-28 Проект: Лишние файлы добавлены в игнор-лист. Игнор-лист: * AtmelStudio/Xmega32A4U_testBoard/Debug * CSharp/Xmega32A4U_Board/bin * CSharp/Xmega32A4U_Board/obj * *.suo * *.atsuo
2013-11-28 C#: Несколько изменений. * Исправлен баг с двойной посылкой. * Улучшено отображение данных измерений на форме. * Трейсификация * Делегат LAM сигнала теперь находится в MC.Counters * Улучшена защита р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
    [main.c]
2013-11-28 C#: Мелочи. Теперь трейсить сообщения можно через МК (.Tester.traceIt(<string>))
2013-11-28 C: Теперь на время передачи (функции transmit) МК приобретает статус UNSTOPPABLE до окончания передачи. (функции transmit имеет блокировку прерываний на время выполнения функции и разрешение прерыван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
2013-12-03 Добавление документации и архива установочного файла программы EDWARDS по управлению TIC'ом
2013-12-03 C#: Регионизация. Чистка. Табуляция.
2013-12-05 Добавление документации по вакуумной системе.
2013-12-09 C,C#: MEGA-UPDATE: 1). С#: Добавление статичного класса TIC.cs (внешний по отношению к классу МК) 2). С#: Статизация класса XMEGA32A4U.cs в MC.cs 3). С#: Реструктуризация и реклассификация проекта 3.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
2013-12-16 C,C#: MEGA-UPDATE: 1). C#: Добавлен модуль TIC.EXT75DX 2). C: Переработка системы обмена данными МК-ПК 2.1). Переименования СОМР -> РС 2.2). Счётчик TCD1 выделен для таймаута (PC_timer) 2.3). Введены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
    [Decoder.h, Initializator.h, conf_board.h, main.c]
2013-12-16 ТОЧКА. С: Запрет прерываний МК в начале инициализации и во время передачи С: Правка длинны массива для передачи результатов счётчикам. С: Настройка USART_PC сделана в ручную. С#: Теперь кнопка "Задат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
2013-12-18 Восстановление после откатов. Добавление документации по TIC
2013-12-20 MEGA-UPDATE: C: 1). Частично убраны gpio функции. В важных местах заменены на обращения к портам через defin'ы 2). Добавлены команды TIC_retransmit, TIC_set_Gauges, TIC_restartMonitoring, TIC_send_TI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
2013-12-23 C,C#: Переработана флаговая система. Теперь MC.Flags содержит управляемые флаги. MC.setFlags - на удаление после проверки. Ускорено обращение к флаговым пинам. Чистка, порядок.
2013-12-23 C,C#: Добавлен LAM сигнал для включения HVE и индикации того, что напряжения выставлены на устройствах SPI. Нехватает только делегата для этого события!
2013-12-23 С,C#: Добавлены делегаты в MC.Service для асинхронных сообщений. Добавлены происшествия с TIC'ом в команду MC.getStatus
2013-12-23 C,C#: Теперь при опросе результатов измерения МК посылает количество прошедших тиков и предделитель. ПК вычисляет сколько же времени прошло на самом деле. MC.Counters.ElapsedTime в миллисекундах
2013-12-23 C#: Правка: MC.Counters.ElapsedTime теперь в миллисекундах
2013-12-28 ТОЧКА: Удалось связать TIC с МК. После двух недель мучений выяснилось, что TIC очень привередлив к скорости обмена данными. Погрешность скорости в 6%, которая имела место, оказалась критичной. Микрок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
2014-01-09 C,C#: Проверка систем. Добавлен ретрансмит в одну сторону (ПК -> МК -> TIC)
2014-01-09 C,C#: Реализован полный ретрансмит (ПК <-> МК <-> TIC) Устранено неконтактное явление на RXE МК (тройнок контакт DB9-3x)
2014-01-09 C: Калибровка частоты USART_PC (см. Issue 85) C#: Улучшен интерфейс связи с TIC. Теперь можно управлять контрастностью дисплея TIC'а при помощи set и get кнопок и текстового поля.
    [Initializator.h, main.c]
2014-01-10 C#: Отлажена работа трансмита в синхронном и асинхронном режимах. Отлажена работа ретрансмита. Теперь тайм ауты управляемы (через MC.Service)
2014-01-13 C,C#: Исправлены команды запроса и установки значений флагов. Реализован тестовый вариант опроса TIC'a МК на предмет HVE. Пока что без датчика оценивается только корректность посылки.
    [Initializator.h, main.c]
2014-01-13 C,C#: Реализован довольно простой менеджмент прерываний (см. Issue 91) Ограничения: При включённом HVE обращать с TIC'у часто не стоит. (перерыв между обращениями более 250мс) В иных случаях без огра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
    [main.c]
2014-01-14 C: Создана заготовка для сравнения значений давлений от TIC'a в единицах давлений
2014-01-15 C#: Чистка, порядок, марафет.
2014-01-15 ТОЧКА: Были протестированы все системы. 1) Исправлена работа счётчиков 2) Чистка
    [Decoder.h, conf_board.h, main.c]
2014-01-16 C: Правка счётчиков. Ускорен запуск счётчиков. Замедлен останов счётчик для того, чтобы overtime RTC адекватно отражал реальность.
2014-01-16 C,C#: Предрелиз. 1). С: МК теперь сам настраивает Ионный Источник после включения HVE 2). С: Активация защиты HVE 3). С#: Доработано событие SPI_devices_ready 4). C#: Функции событий теперь вызываютс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
2014-01-23 C: Оптимизация прерывания по приёму байтов от TIC
2014-01-23 C: Оптимизация приём байтов от TIC
2014-01-23 C: Оптимизация прерывания по приёму байтов от PC
2014-01-24 C: Оптимизация таймера PC +Чистка
2014-01-24 C: Мониторинг HVE переключён на напряжения.
2014-01-28 С#: TIC: Исправлены вызовы внешних функций при не нулевом priority и alert'е
2014-02-07 ТОЧКА: Первый запуск. Результаты: + Микроконтроллер отзывается + TIC распознаёт устройства + Форнасос включился автоматически Исправления: + Исправлены недочёты ревизии r153
    [Initializator.h, main.c]
2014-02-07 С#: Улучшен интерфейс управления TIC'ом. Подготовка к дальнейшим тестам. Результаты недавних испытаний: + Течь в высоковакуумной части после вентиля SEMV1 + Постоянно работает форвакуумный насос. TIC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
2014-02-10 C#: Запуск. Улучшен интерфейс программы -> управление насосами и датчиками TIC'а Проверено: + Целостность вакуумной системы + Турбомолекулярный насос + Датчики + Датчики присылают давление в паскалях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
2014-02-11 C,C#: Запуск. Реализована система опроса давлений датчиков. + Теперь МК проверяет давления на датчиках + Оперирует float значениями (операция длится 500 мкс) + Давления в Па В результаты запуска: + П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
2014-02-11 C#: Заблокированы функции настройки мониторинга HVE
2014-03-11 C,C#: 1). С: Уточнены стартовые настройки DAC'ов при включении HVE 2). С: Исправлено заваливание ПК сообщениями о неотвечающем TIC'e. Теперь сообщение будет послано только 1 раз. 3). С: Теперь RTC вк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
    [Decoder.h, main.c]
2014-04-28 Изменение протокола обмена ПК<->МК. Применён протокол "Радист-1"
2014-04-29 Протокол обмена ПК<->МК вновь изменён. Радист-2
2014-06-30 C: Исправление бага связанного с встраиванием пакета во время прерывания, когда микроконтроллер уже осуществлял отправку пакета. Теперь пакет атомарно заталкивается в буфер, проверяется состояние "ид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
    [Radist.h, main.c]
2014-07-02 C: Каждые 200 мс МК запрашивает у TIC'а, статус. По которому МК включает вентиль EMV1 и разрешает высокие напряжения. Теперь нет сложной обработки численного значения давления. Теперь все пороги прог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
2014-07-04 C: Множественные изменения: + Добавлена новая команда: COUNTERS_delayedStart Команда: <33><SV.1><SV.2><PSV.1><PSV.2><C.1><C.2><delay_ms.1><delay_ms.2><measure_ms.1><measure_ms.2><cs> командный байт, 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
2014-07-09 C: Мелкие улучшения + Теперь при установке напряжений при команде COUNTERS_delayedStart, ПК должен посылать двубайтное число от 0 до 16383. МК сам сдвигает значение на два бита. + Добавлен ещё один б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
2014-07-09 C: Чистка
2014-07-09 C: Исправлена ошибка. В ответ на TIC_getStatus, МК присылал сообщение от TIC'а без метки команды.
    [main.c]
2014-07-10 C: Изменения по HVE + Теперь МК при включении высокого напряжение также конфигурирует на двойной референс и DAC натекателя + Исправлено выполнение команды SPI_get_AllVoltages. Теперь оно несколько то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
    [main.c]
2014-07-14 C: Война с дрожанием контактов датчиков + Добавлен счёт дребезга статуса R1: датчика для вентиля EMV1. + Изменено максимальное начальное максимальное количество дребезга с 1 до 5 + Изменено условие с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
    [Decoder.h, main.c]
2014-07-14 C: Теперь все ЦАП'ы конфигурируются на двойной референс при любом обращении к любому SPI устройству
2014-07-15 C: Изменена скорость обмена MC<->PC на 115200. Теперь есть комментарийный выбор (+ещё две скорости 57600 и 38400). + Изменено время таймаута по приёму до полусекунды. На всякий случай. Может сказатьс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
2015-09-04 Пробная синхронизация
2015-09-04 C: Подготовка к TIC_Default_Problem
